Chloxeo/SCALAR-7_IHM/images/BOTTOM.png

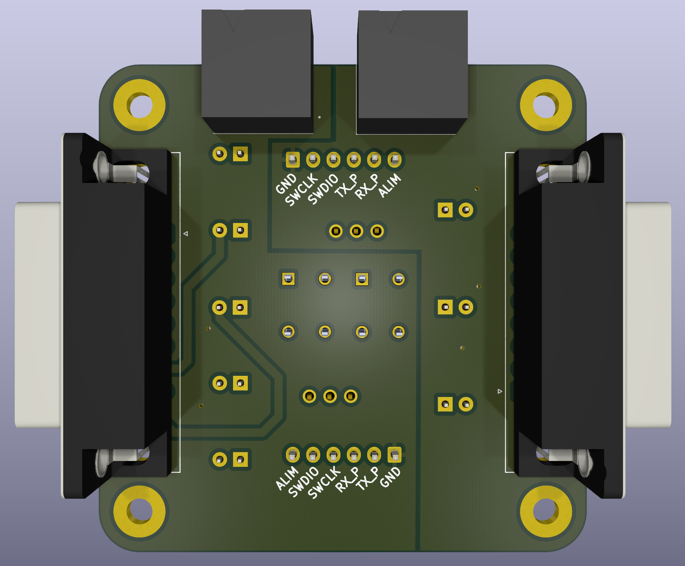
images/BOTTOM.png
