Chloxeo/SCALAR-7_IHM/images/FRONT.png

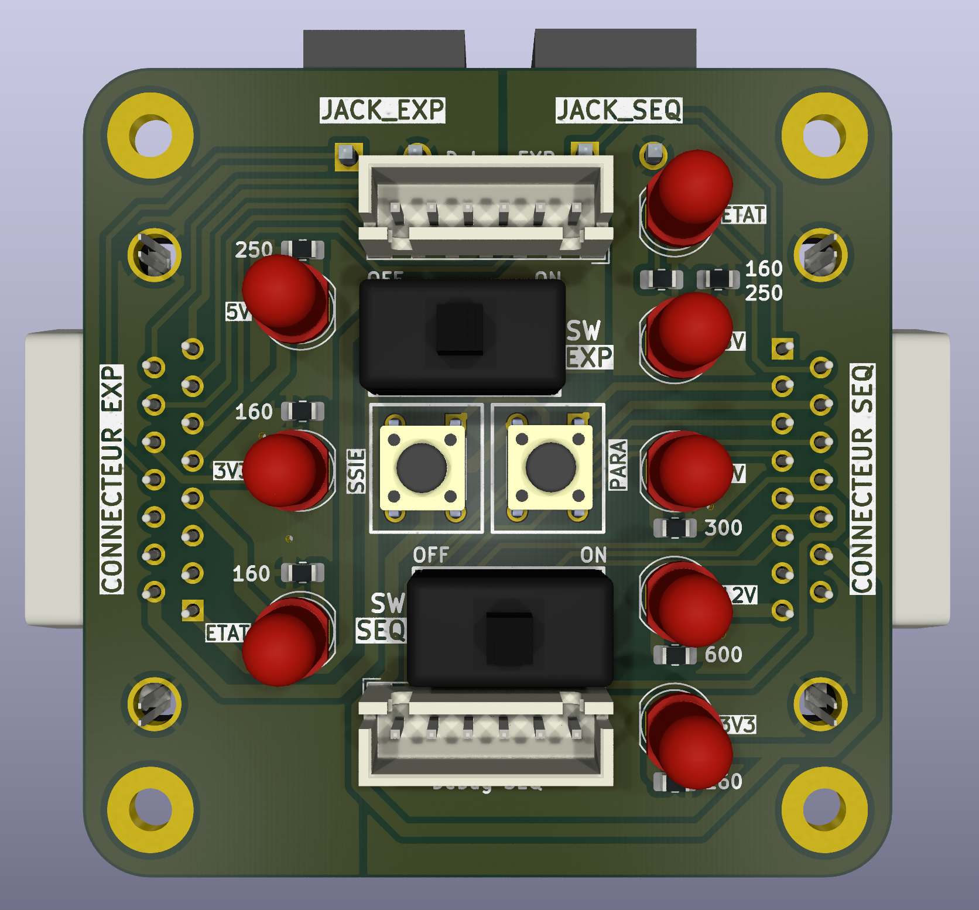
images/FRONT.png
