Chloxeo/SCALAR-7_IHM/schematic.pdf

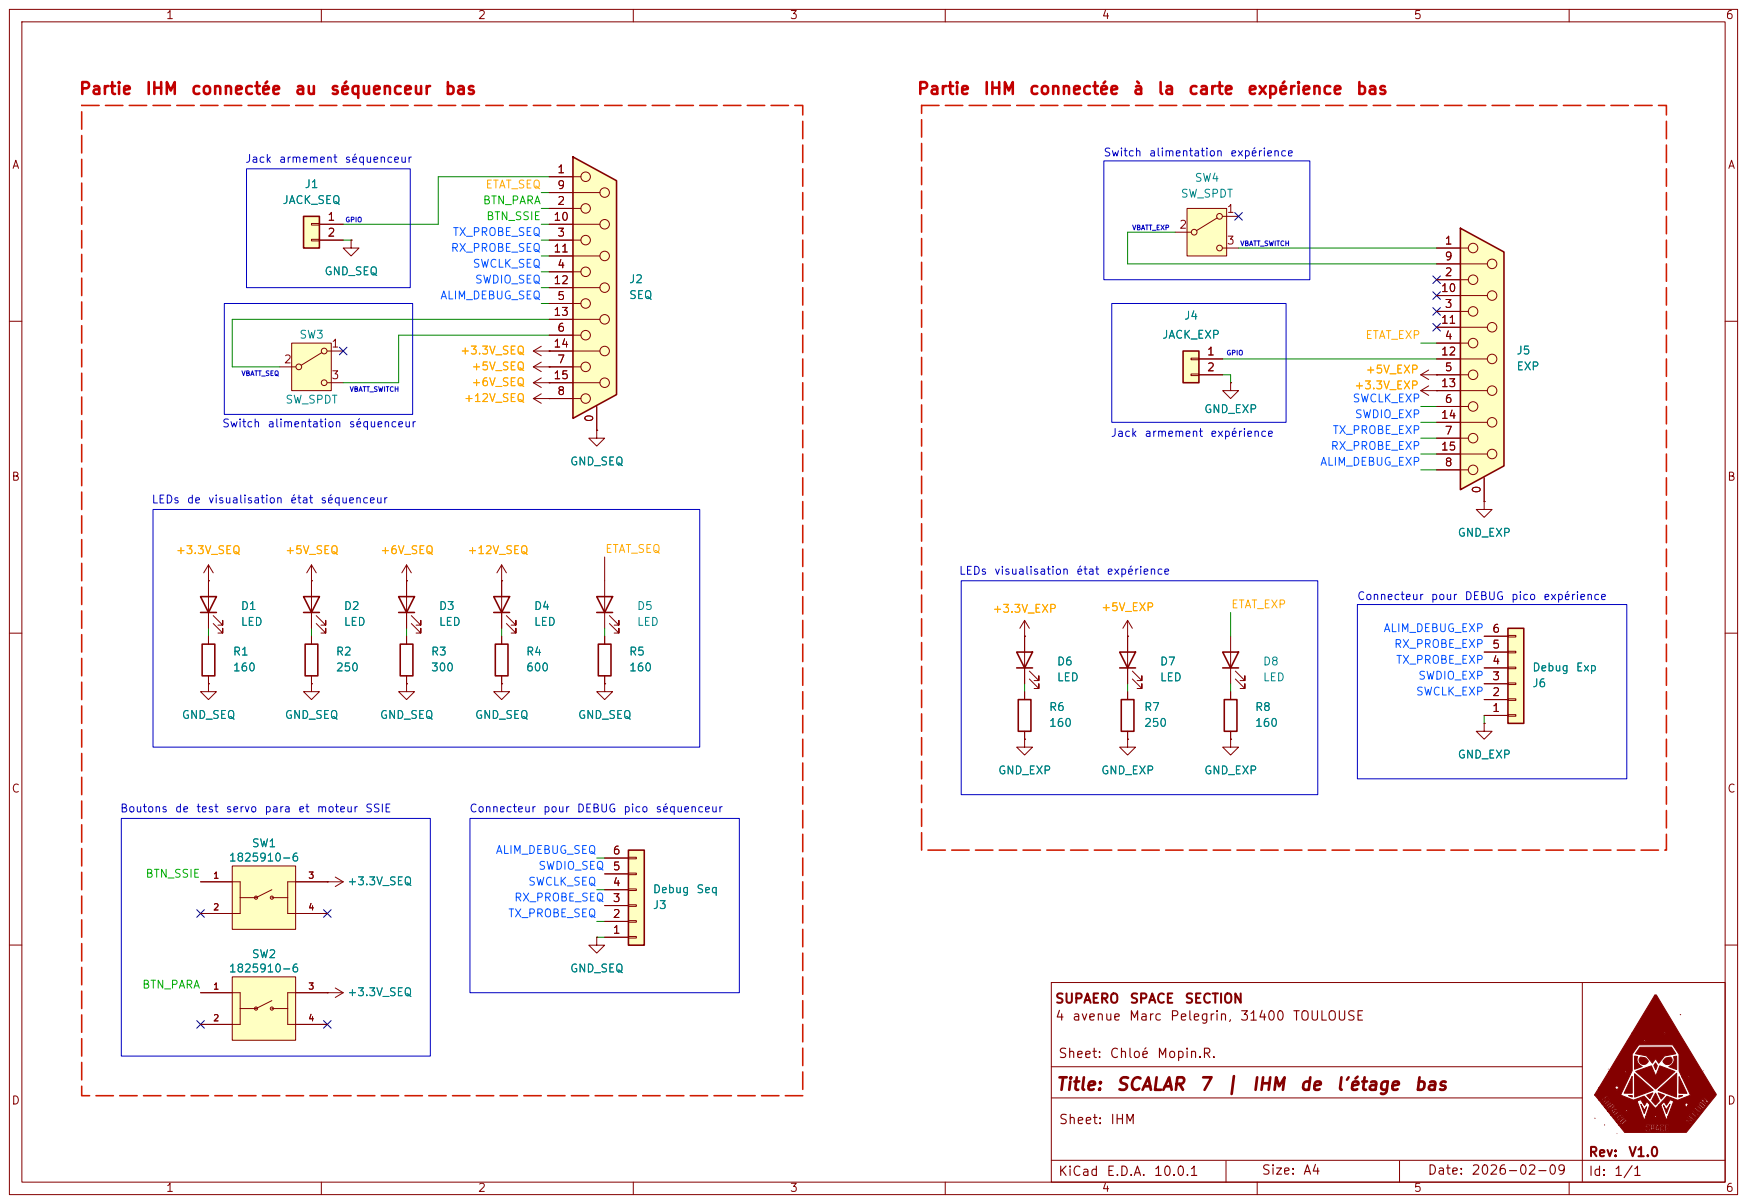
[picture p4: page 1]

GPIO Partie IHM connectée au séquenceur bas

Partie IHM connectée à la carte expérience bas

VBATT_EXP Switch alimentation séquenceur Jack armement séquenceur

SUPAERO SPACE SECTION
4 avenue Marc Pelegrin, 31400 TOULOUSE

Title: SCALAR 7 | IHM de l'étage bas
Sheet: IHM
