Chloxeo/SCALAR-7_IHM/hardware/IHM.kicad_pcb

## KiCad design hardware/IHM.kicad_pcb (2026-11-06)

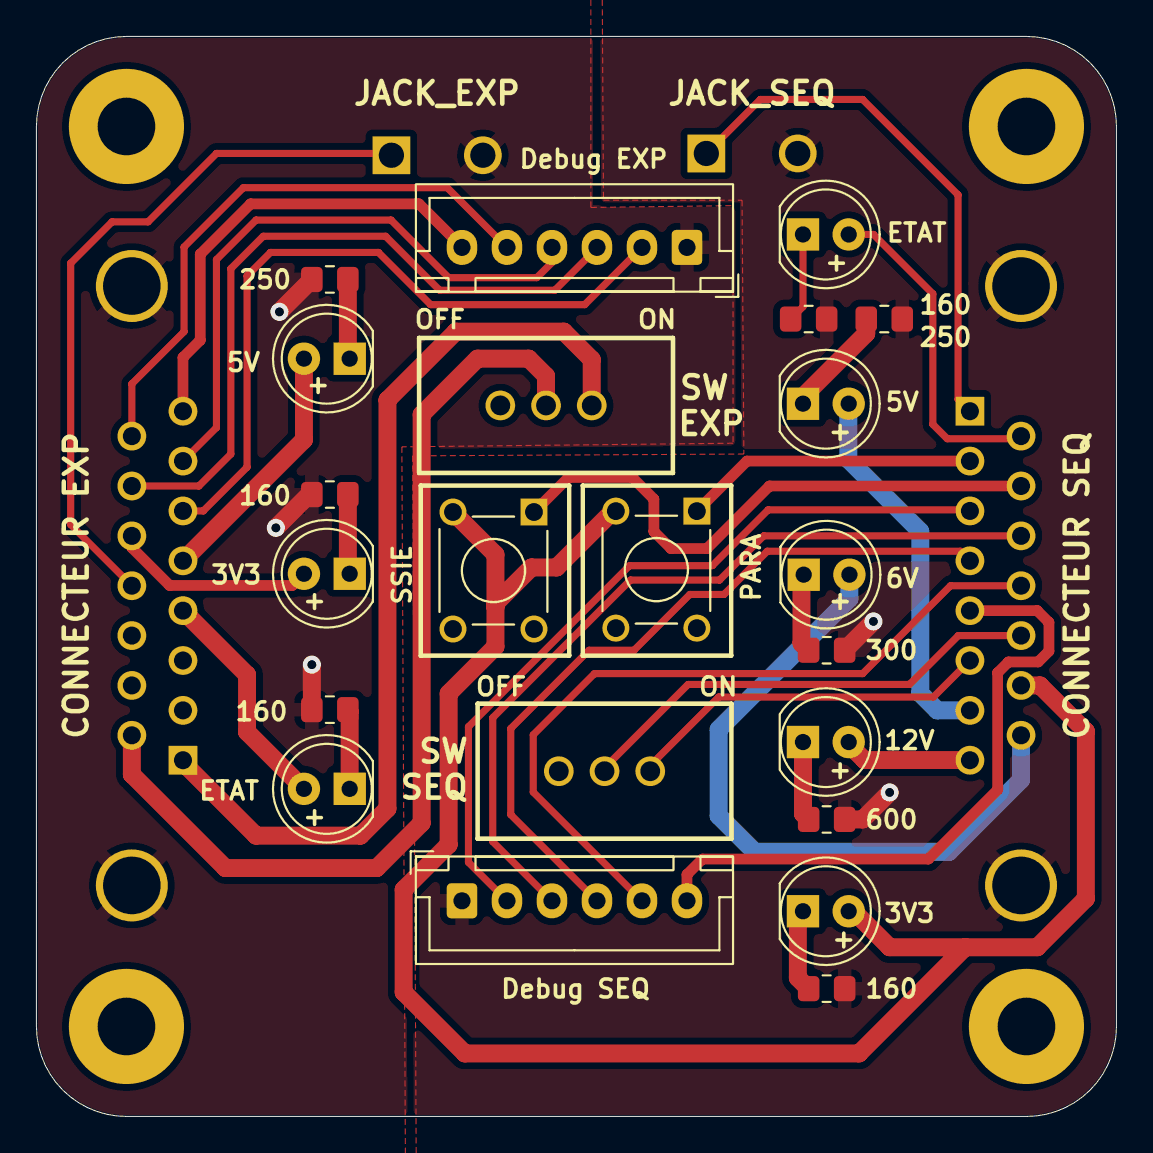
[picture p5: board IHM.kicad_pcb from above]

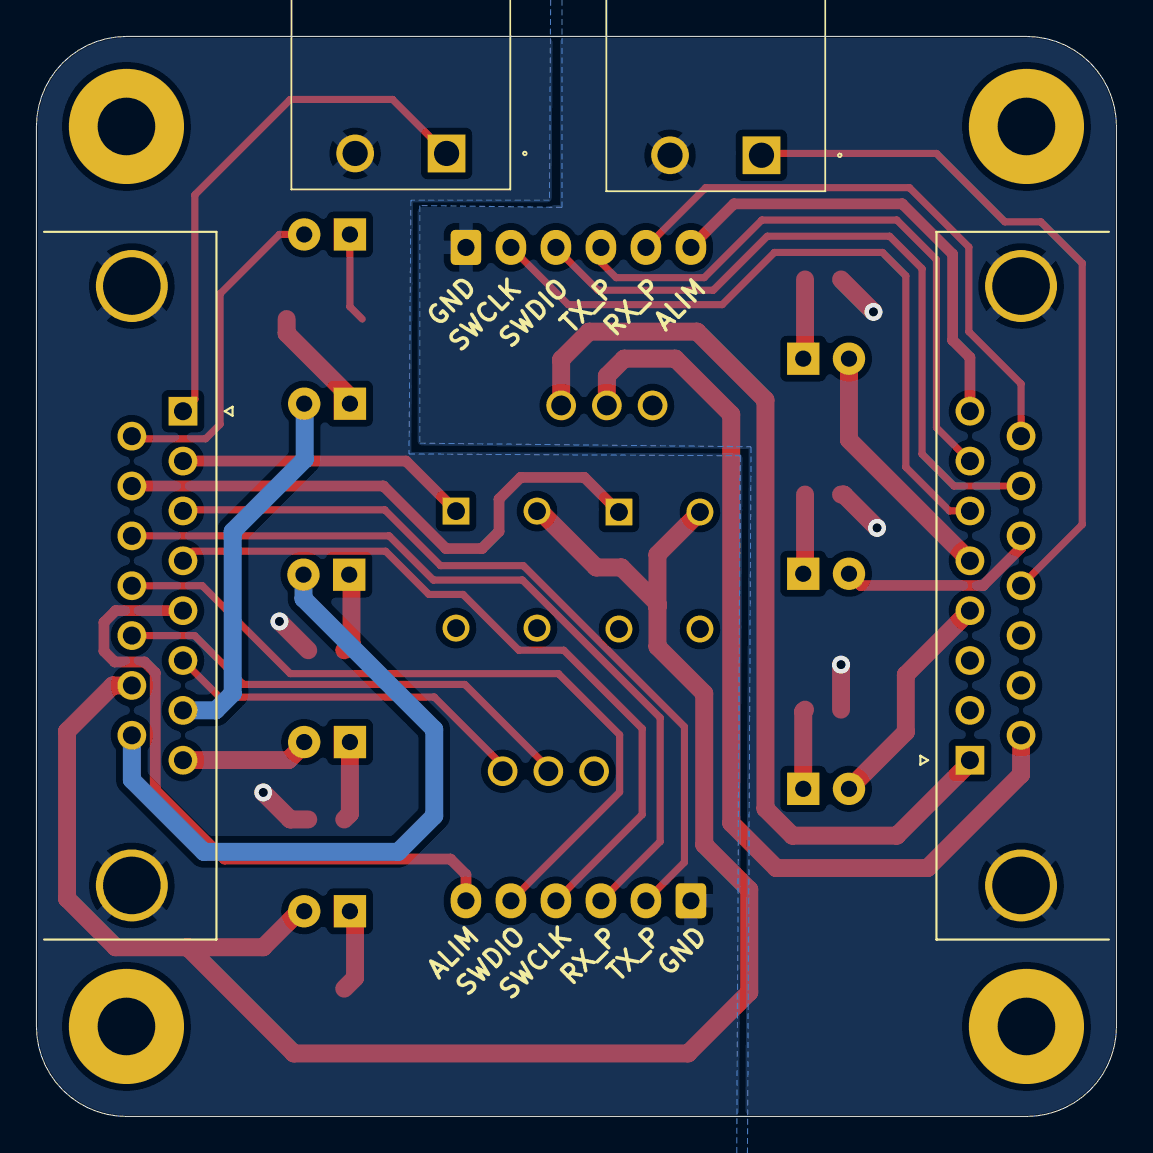
[picture p6: board IHM.kicad_pcb from below]

Board: 2 copper layers, 60.0 x 60.0 mm, 30 parts (4 on the bottom side), 36 nets.

Parts:
D1, D2, D3, D4, D5, D6, D7, D8: LED; LED_D5.0mm
H1, H2, H3, H4: MountingHole; MountingHole_3.2mm_M3_Pad
J1: JACK_SEQ; Bornier_Enfichable_2Pin_5mm_Horizontal
J2: CONNECTEUR SEQ; DSUB-15_Pins_Horizontal_P2.77x2.84mm_EdgePinOffset4.94mm_Ho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
J3: Debug SEQ; JST_XH_B6B-XH-A_1x06_P2.50mm_Vertical
J4: JACK_EXP; Bornier_Enfichable_2Pin_5mm_Horizontal
J5: CONNECTEUR EXP; DSUB-15_Pins_Horizontal_P2.77x2.84mm_EdgePinOffset4.94mm_Ho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
J6: Debug EXP; JST_XH_B6B-XH-A_1x06_P2.50mm_Vertical
R1, R5, R6, R8: 160; R_0805_2012Metric_Pad1.20x1.40mm_HandSolder
R2, R7: 250; R_0805_2012Metric_Pad1.20x1.40mm_HandSolder
R3: 300; R_0805_2012Metric_Pad1.20x1.40mm_HandSolder
R4: 600; R_0805_2012Metric_Pad1.20x1.40mm_HandSolder
SW1: SSIE; SW_1825910-6-4
SW2: PARA; SW_1825910-6-4
SW3: SEQ; 25139NAH
SW4: EXP; 25139NAH

Connections:
+3.3V_EXP: D6.2 (A), J5.13
+3.3V_SEQ: D1.2 (A), J2.14, SW1.3, SW2.3
+5V_EXP: D7.2 (A), J5.5
+5V_SEQ: D2.2 (A), J2.7
+6V_SEQ: D3.2 (A), J2.15
+12V_SEQ: D4.2 (A), J2.8
/ALIM_DEBUG_EXP: J5.8, J6.6
/ALIM_DEBUG_SEQ: J2.5, J3.6
/BTN_PARA: J2.2, SW2.1
/BTN_SSIE: J2.10, SW1.1
/ETAT_EXP: D8.2 (A), J5.4
/ETAT_SEQ: D5.2 (A), J2.9
/RX_PROBE_EXP: J5.15, J6.5
/RX_PROBE_SEQ: J2.11 (P111), J3.3
/SWCLK_EXP: J5.6, J6.2
/SWCLK_SEQ: J2.4, J3.4
/SWDIO_EXP: J5.14, J6.3
/SWDIO_SEQ: J2.12, J3.5
/TX_PROBE_EXP: J5.7, J6.4
/TX_PROBE_SEQ: J2.3, J3.2
GND_EXP: J4.2, J5.0 (PAD), J6.1, R6.2, R7.2, R8.2
GND_SEQ: J1.2, J2.0 (PAD), J3.1, R1.2, R2.2, R3.2, R4.2, R5.2
unnamed: D1.1 (K), R1.1
unnamed: D2.1 (K), R2.1
unnamed: D3.1 (K), R3.1
unnamed: D4.1 (K), R4.1
unnamed: D5.1 (K), R5.1
unnamed: D6.1 (K), R6.1
unnamed: D7.1 (K), R7.1
unnamed: D8.1 (K), R8.1
unnamed: J1.1, J2.1
unnamed: J2.13, SW3.2 (B)
unnamed: J4.1, J5.12
unnamed: J5.9, SW4.2 (B)
unnamed: J2.6, SW3.3 (C)
unnamed: J5.1, SW4.3 (C)
